roetske/adjustable-pulse-24V/Schematic24_adjustabalepulse.png

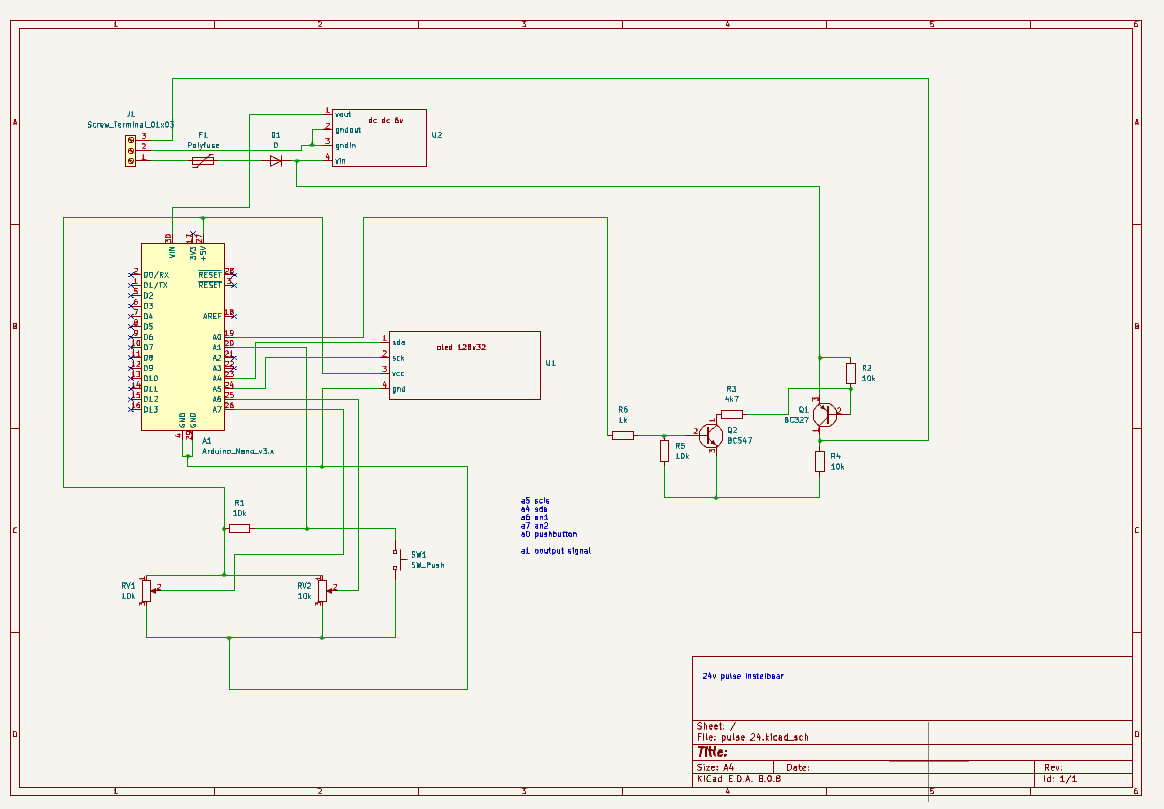
Schematic24_adjustabalepulse.png
